tonyp7/GenDumper/hardware/schematics/mega-dumper-schematics-page1.png

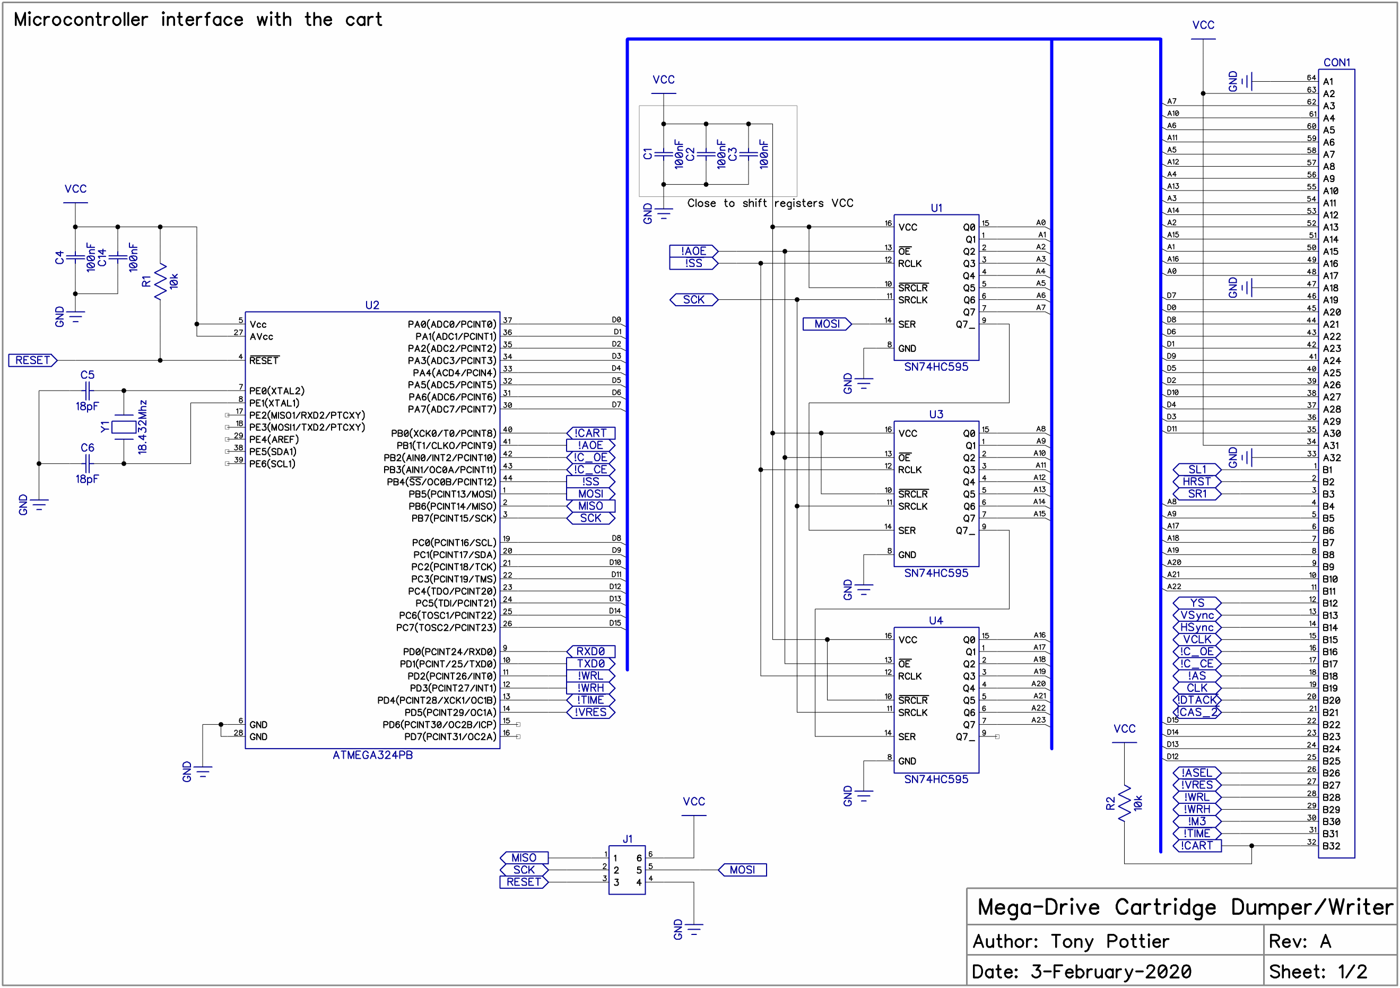
hardware/schematics/mega-dumper-schematics-page1.png
