tonyp7/GenDumper/hardware/schematics/mega-dumper-schematics-page2.png

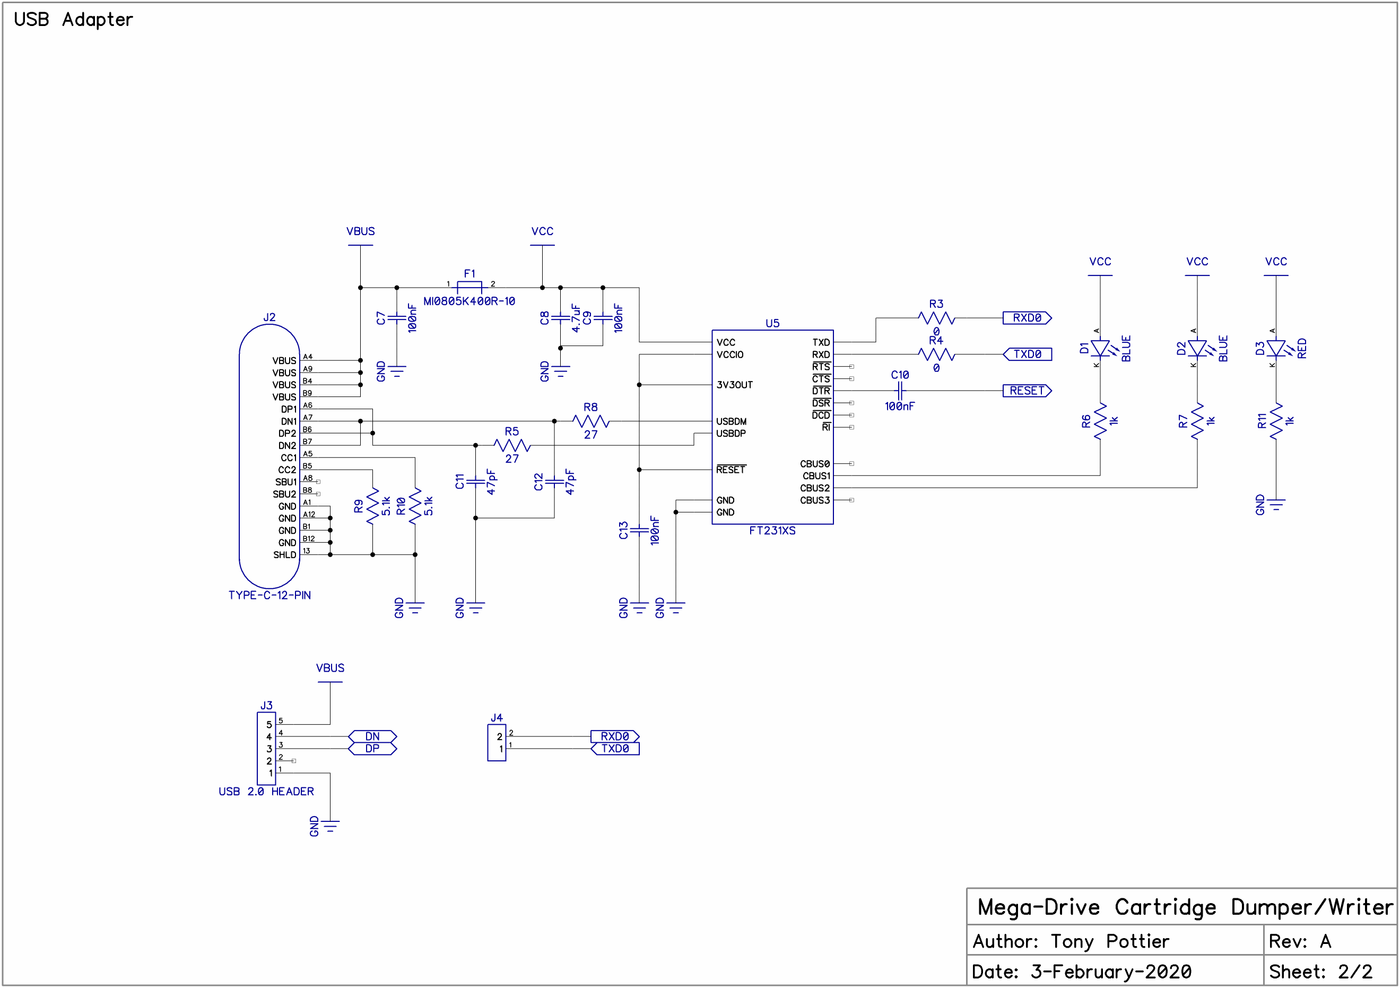
hardware/schematics/mega-dumper-schematics-page2.png
