tonyp7/GenDumper/pictures/mega-dumper-nhl.jpg

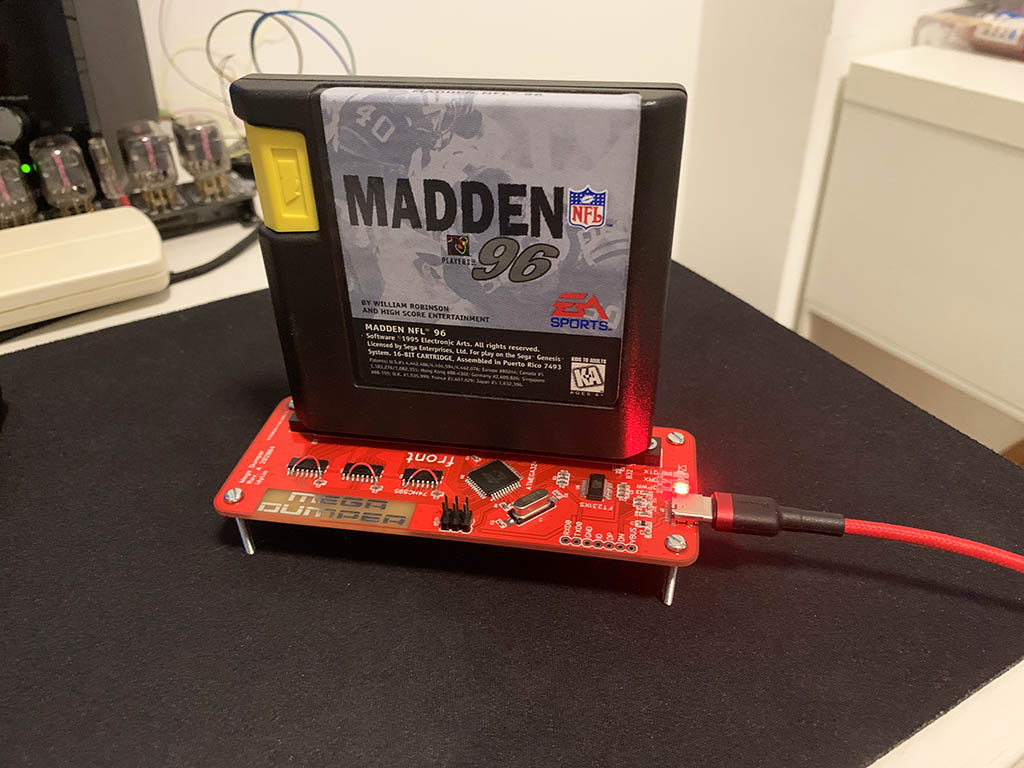
pictures/mega-dumper-nhl.jpg
