tonyp7/GenDumper/pictures/mega-dumper-no-cart.jpg

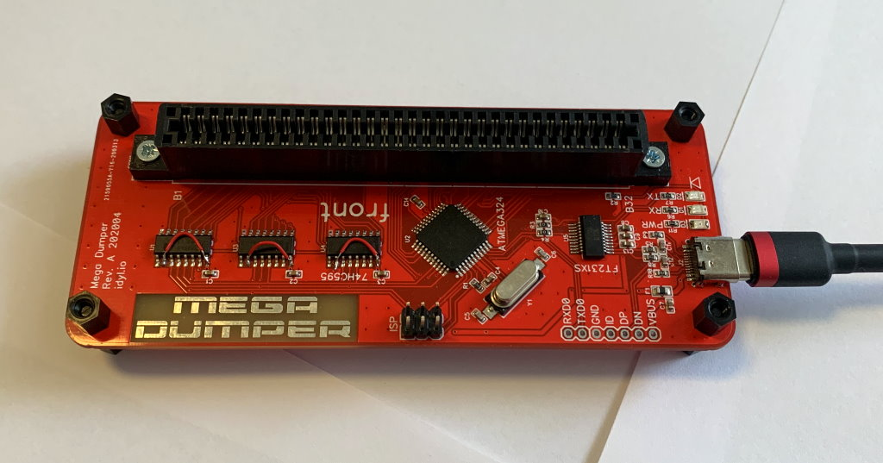
pictures/mega-dumper-no-cart.jpg
