tonyp7/GenDumper/hardware/schematics/mega-dumper-schematics.pdf

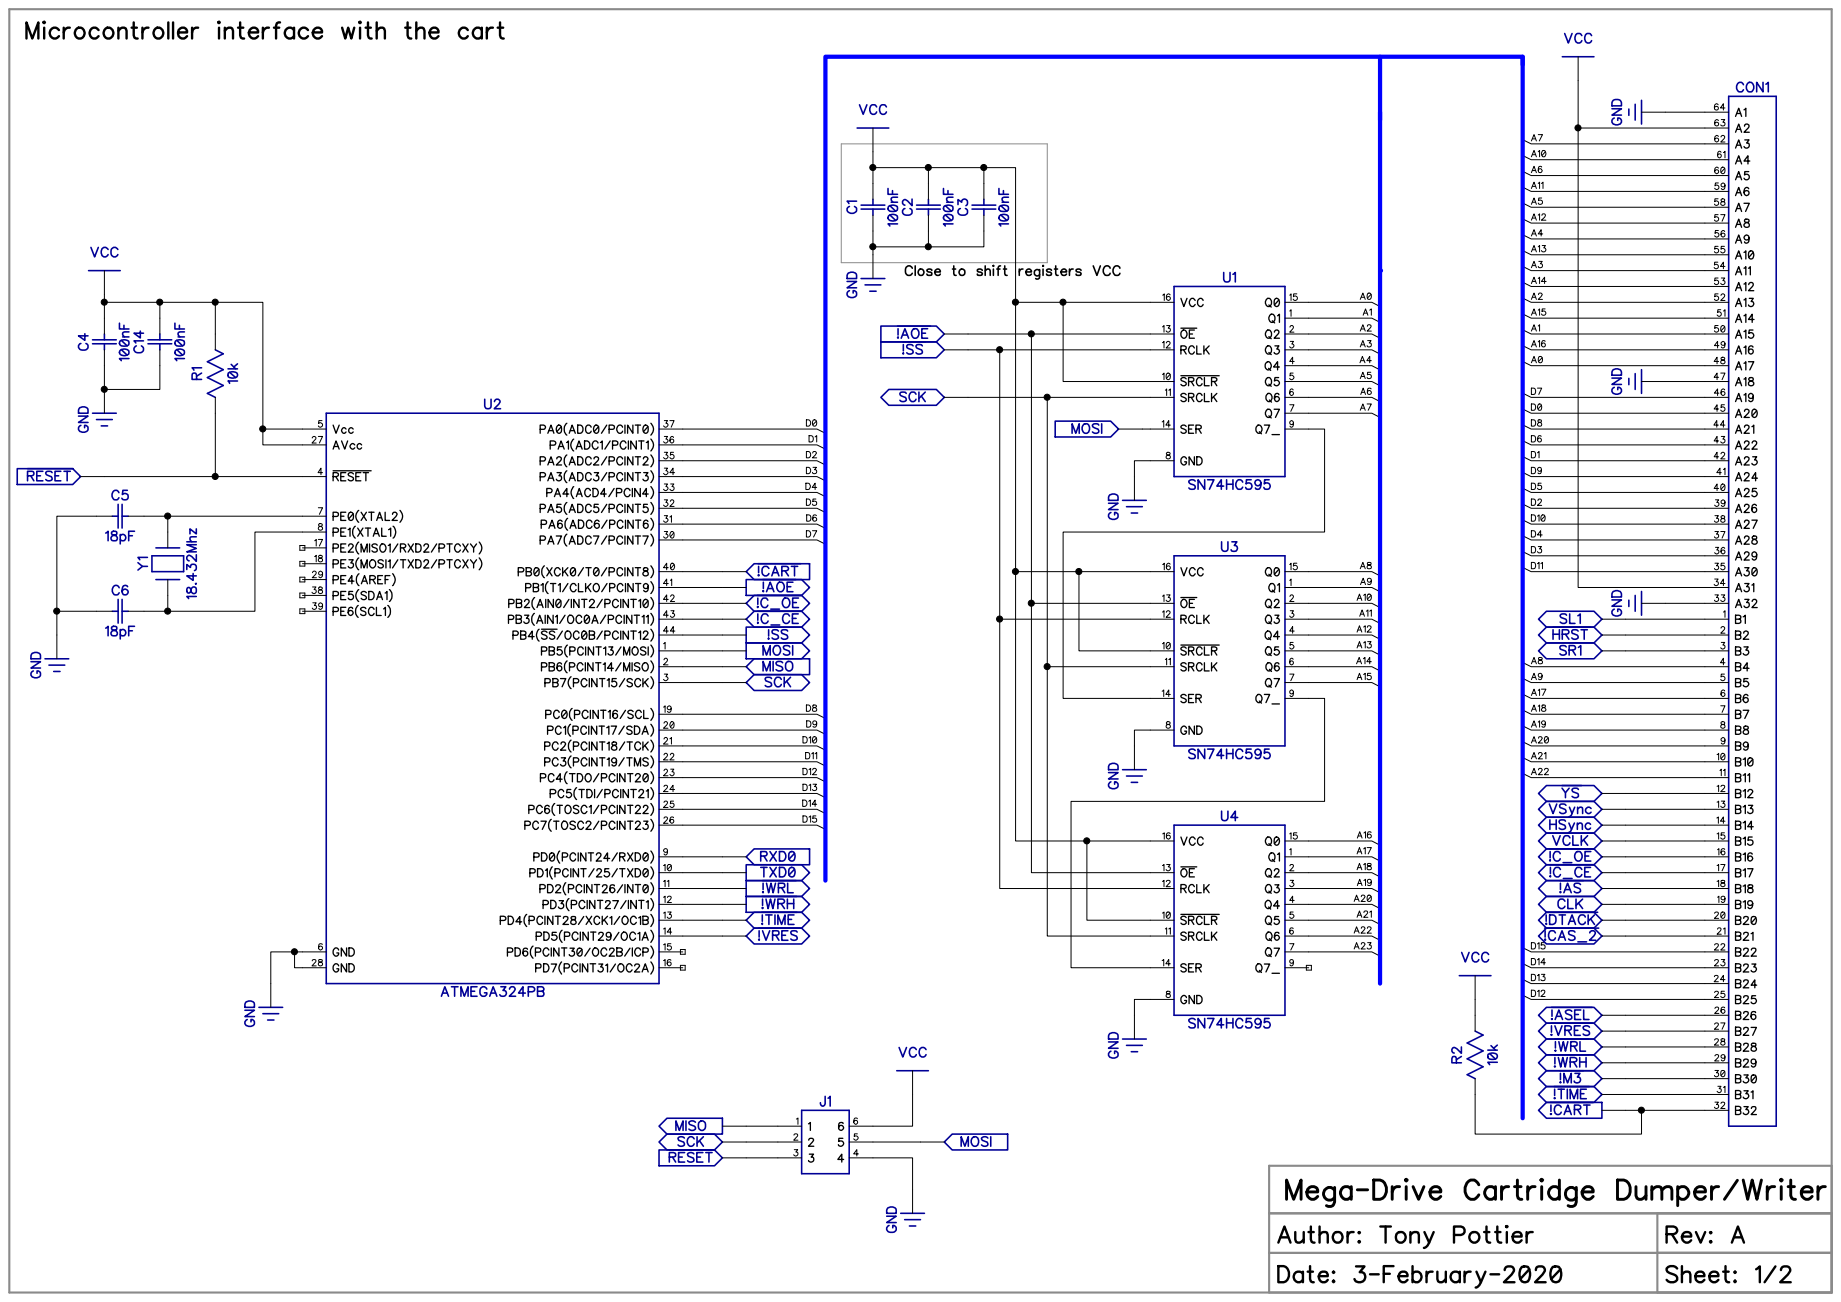
[picture p6: page 1]

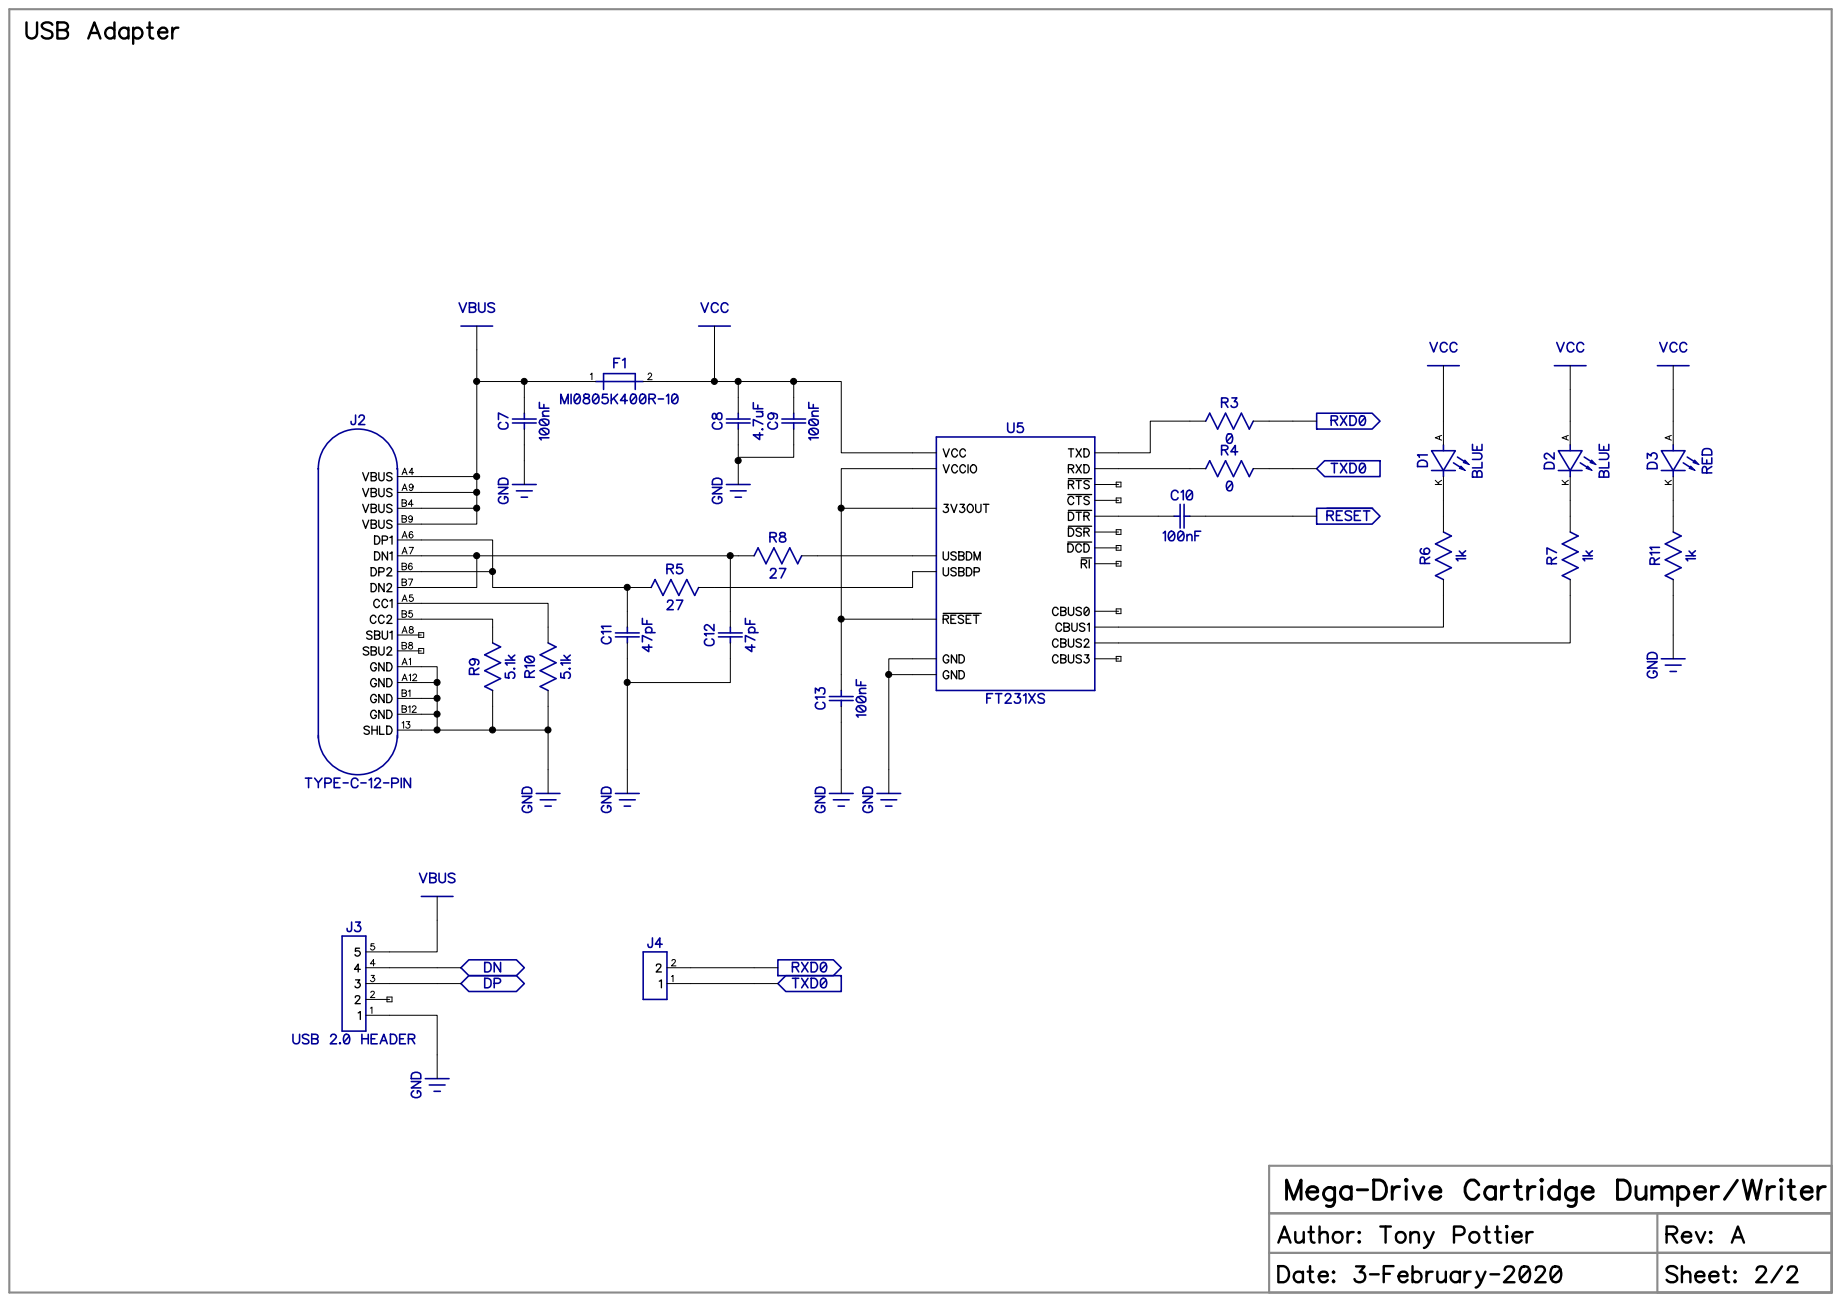
[picture p7: page 2]
