tonyp7/GenDumper/(commit log)

2020-04-10 hardware schematics
2020-04-12 serial port auto detection
    shameless copy/paste from: https://stackoverflow.com/questions/4199083/detect-serial-port-insertion-removal
2020-04-18 added an additional NOP
    I noticed the dump contains weird errors if waiting for only 100ns. This fixes the issue.
    [ArduinoGenDumper.ino]
2020-04-19 it works
    Many improvements in these changes. now if you click the dump button the program succesfully retrieve the cart size, dump it, and save to file.
